adafruit/Adafruit-BMP3xx-PCB/Adafruit BMP388 QT.brd

## EAGLE design Adafruit BMP388 QT.brd (2021-02-23)

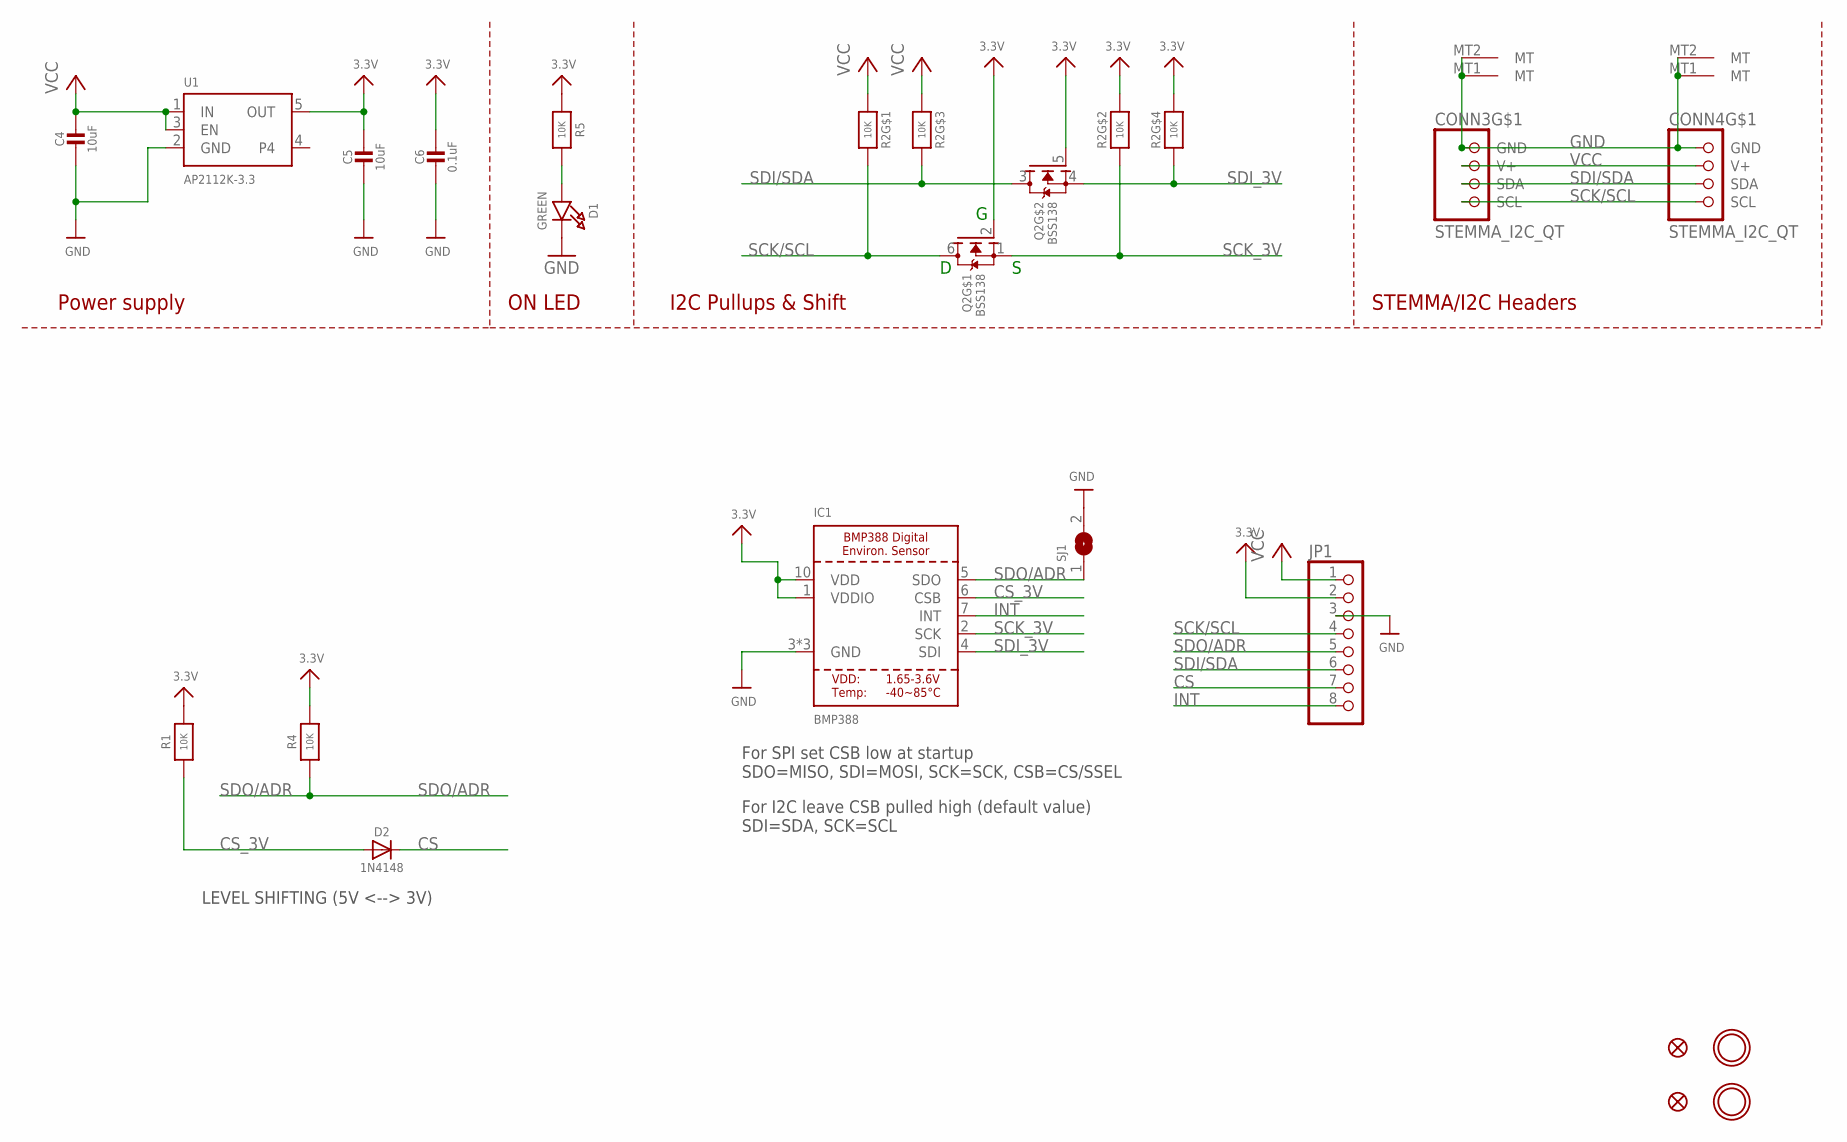
[picture p4: schematic Adafruit BMP388 QT.sch]

Parts:
C4, C5: 10uF; 0805-NO
C6: 0.1uF; 0603-NO
CONN3, CONN4: STEMMA_I2C_QT; JST_SH4
D1: GREEN; CHIPLED_0603_NOOUTLINE
D2: 1N4148; SOD-323
FID3, FID4: FIDUCIAL_1MM
IC1: BMP388
JP1: HEADER-1X870MIL; 1X08_ROUND_70
Q2: BSS138; SOT363
R1, R4, R5: 10K; 0603-NO
R2: 10K; RESPACK_4X0603
SJ1: SOLDERJUMPER; SOLDERJUMPER_ARROW_NOPASTE
U1: AP2112K-3.3; SOT23-5
U$40, U$41: MOUNTINGHOLE2.5; MOUNTINGHOLE_2.5_PLATED

Connections:
3.3V: C5.1, C6.1, IC1.1 (VDDIO), IC1.10 (VDD), JP1.2, Q2.2 (G), Q2.5 (G), R1.2, R2.2 (1), R2.4 (1), R4.2, R5.1, U1.5 (OUT)
CS: D2.C, JP1.7
CS_3V: D2.A, IC1.6 (CSB), R1.1
GND: C4.2, C5.2, C6.2, CONN3.1 (GND), CONN3.MT1 (MT), CONN3.MT2 (MT), CONN4.1 (GND), CONN4.MT1 (MT), CONN4.MT2 (MT), D1.C, IC1.3 (GND), IC1.8 (GND), IC1.9 (GND), JP1.3, SJ1.2, U1.2 (GND)
INT: IC1.7 (INT), JP1.8
unnamed: D1.A, R5.2
SCK/SCL: CONN3.4 (SCL), CONN4.4 (SCL), JP1.4, Q2.6 (D), R2.8 (2)
SCK_3V: IC1.2 (SCK), Q2.1 (S), R2.7 (2)
SDI/SDA: CONN3.3 (SDA), CONN4.3 (SDA), JP1.6, Q2.3 (D), R2.6 (2)
SDI_3V: IC1.4 (SDI), Q2.4 (S), R2.5 (2)
SDO/ADR: IC1.5 (SDO), JP1.5, R4.1, SJ1.1
VCC: C4.1, CONN3.2 (V+), CONN4.2 (V+), JP1.1, R2.1, R2.3 (1), U1.1 (IN), U1.3 (EN)

Notes on the sheet:
I2C Pullups & Shift
STEMMA/I2C Headers
ON LED
Power supply
For SPI set CSB low at startup SDO=MISO, SDI=MOSI, SCK=SCK, CSB=CS/SSEL
For I2C leave CSB pulled high (default value) SDI=SDA, SCK=SCL
LEVEL SHIFTING (5V <--> 3V)

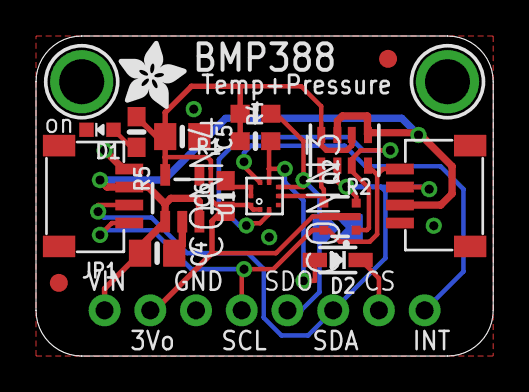
[picture p5: board Adafruit BMP388 QT.brd from above]

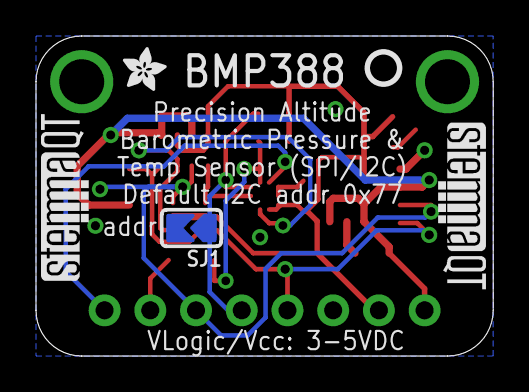
[picture p6: board Adafruit BMP388 QT.brd from below]

Board: 2 copper layers, 25.4 x 17.8 mm, 25 parts (5 on the bottom side), 12 nets.

Other parts of the board:
U$2: ADAFRUIT_2.5MM
U$46: ADAFRUIT_3.5MM
U$47: PCBFEAT-REV-040
U$48, U$49: STEMMAQT
