adafruit/Adafruit-BMP3xx-PCB/Adafruit BMP388.brd

## EAGLE design Adafruit BMP388.brd (2018-11-02)

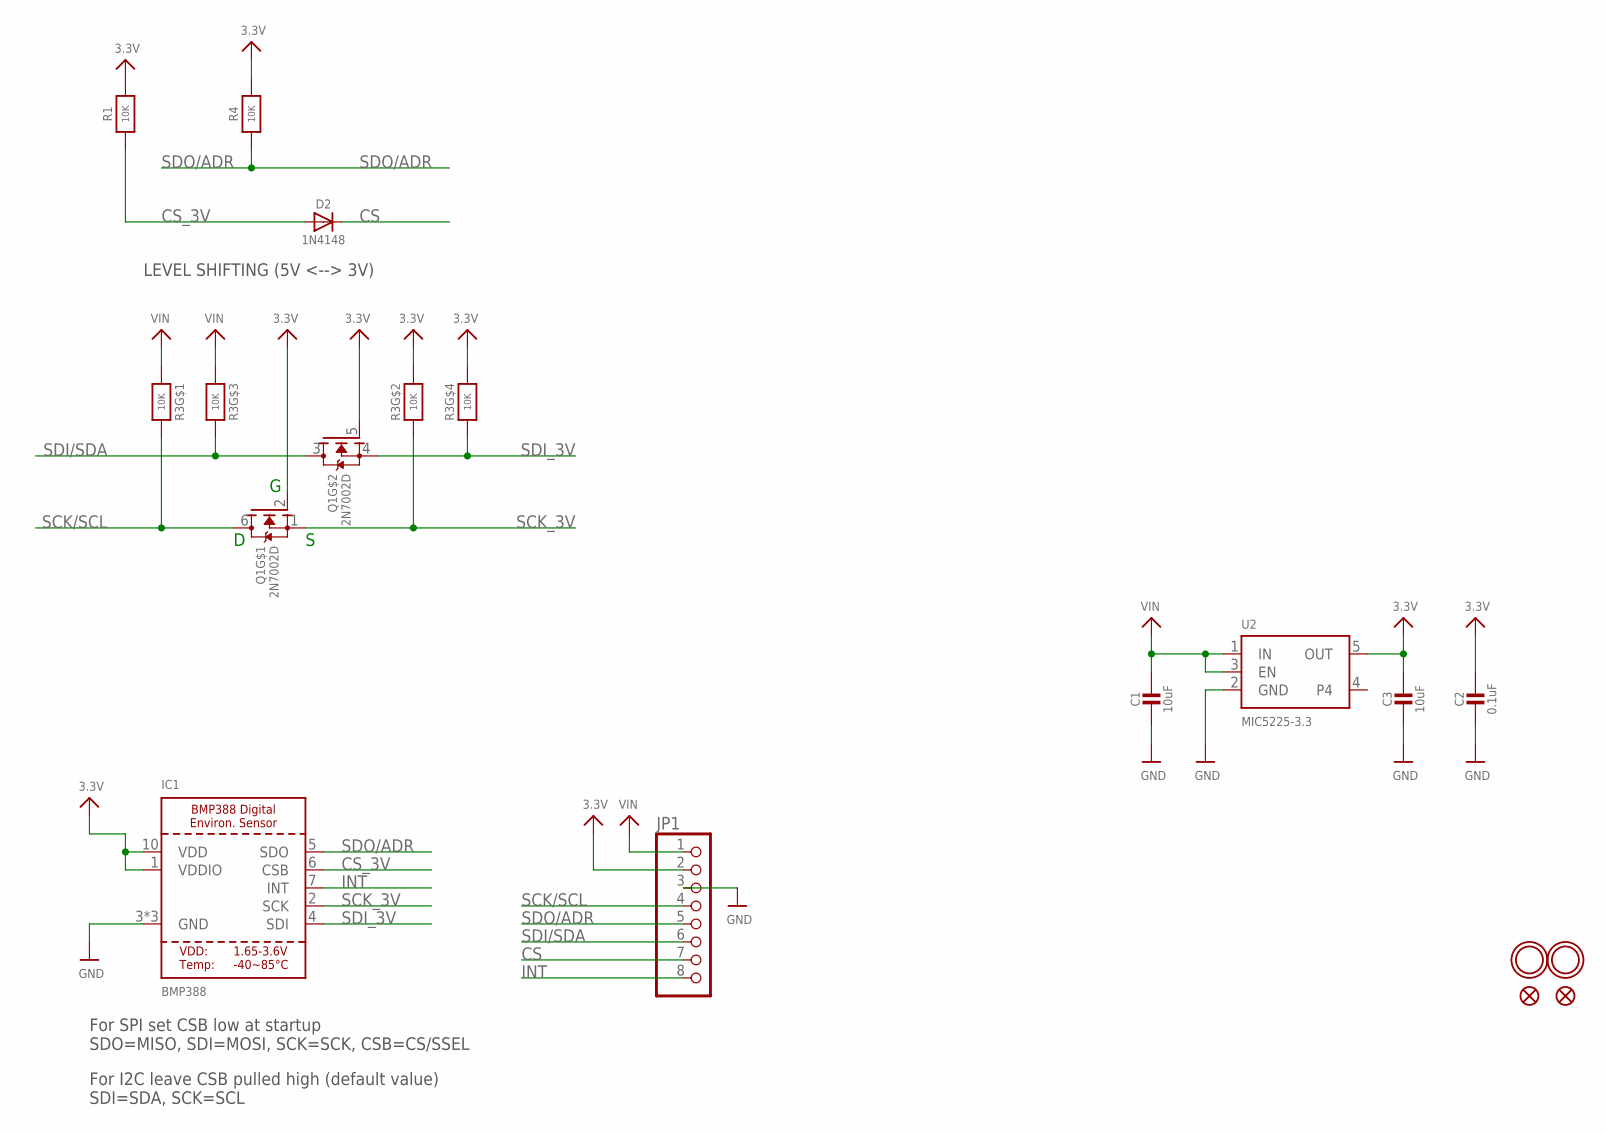
[picture p7: schematic Adafruit BMP388.sch]

Parts:
C1, C3: 10uF; 0805-NO
C2: 0.1uF; 0603-NO
D2: 1N4148; SOD-323
IC1: BMP388
JP1: HEADER-1X870MIL; 1X08_ROUND_70
Q1: 2N7002D; SOT363
R1, R4: 10K; 0603-NO
R3: 10K; RESPACK_4X0603
U2: MIC5225-3.3; SOT23-5
U$5, U$15: FIDUCIAL_1MM
U$7, U$8: MOUNTINGHOLE2.0; MOUNTINGHOLE_2.0_PLATED

Connections:
3.3V: C2.1, C3.1, IC1.1 (VDDIO), IC1.10 (VDD), JP1.2, Q1.2 (G), Q1.5 (G), R1.2, R3.2 (1), R3.4 (1), R4.2, U2.5 (OUT)
CS: D2.C, JP1.7
CS_3V: D2.A, IC1.6 (CSB), R1.1
GND: C1.2, C2.2, C3.2, IC1.3 (GND), IC1.8 (GND), IC1.9 (GND), JP1.3, U2.2 (GND)
INT: IC1.7 (INT), JP1.8
SCK/SCL: JP1.4, Q1.6 (D), R3.8 (2)
SCK_3V: IC1.2 (SCK), Q1.1 (S), R3.7 (2)
SDI/SDA: JP1.6, Q1.3 (D), R3.6 (2)
SDI_3V: IC1.4 (SDI), Q1.4 (S), R3.5 (2)
SDO/ADR: IC1.5 (SDO), JP1.5, R4.1
VIN: C1.1, JP1.1, R3.1, R3.3 (1), U2.1 (IN), U2.3 (EN)

Notes on the sheet:
For SPI set CSB low at startup SDO=MISO, SDI=MOSI, SCK=SCK, CSB=CS/SSEL
For I2C leave CSB pulled high (default value) SDI=SDA, SCK=SCL
LEVEL SHIFTING (5V <--> 3V)

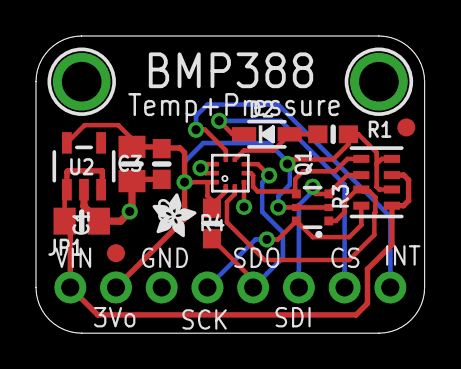
[picture p8: board Adafruit BMP388.brd from above]

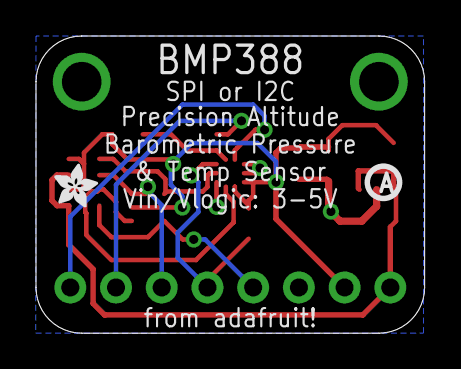
[picture p9: board Adafruit BMP388.brd from below]

Board: 2 copper layers, 21.6 x 16.5 mm, 18 parts (2 on the bottom side), 11 nets.

Other parts of the board:
U$2, U$6: ADAFRUIT_2.5MM
U$20: PCBFEAT-REV-040
