adafruit/Adafruit-BMP3xx-PCB/(commit log)

2019-07-16 updated to new pcb repo cookiecutter
2020-11-04 Add board files.
    [Adafruit BMP390.brd, Adafruit BMP390.sch]
2021-02-23 Add board files
    [Adafruit BMP388 QT.brd, Adafruit BMP388 QT.sch]
